FrankBetances/proyecto-lua/renders/muneco-iso.png

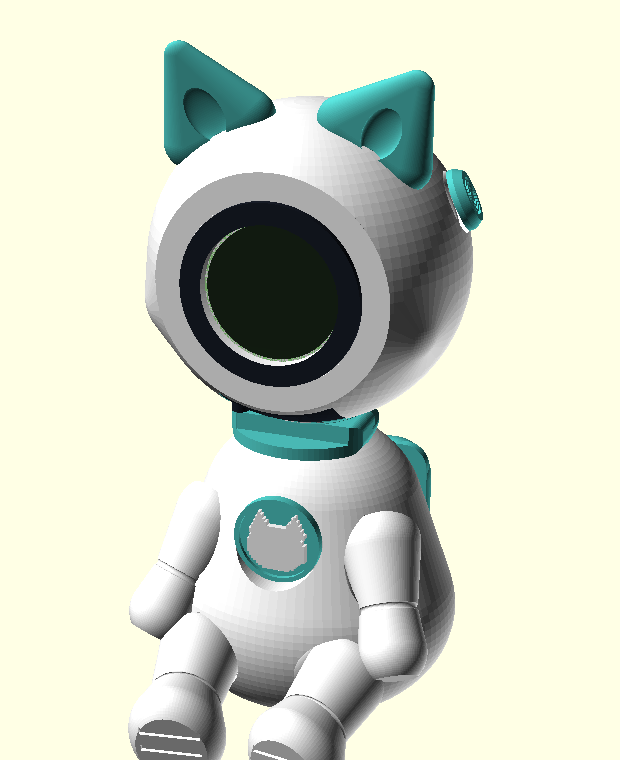
renders/muneco-iso.png
