FrankBetances/proyecto-lua/stl/cabeza_dorso.stl

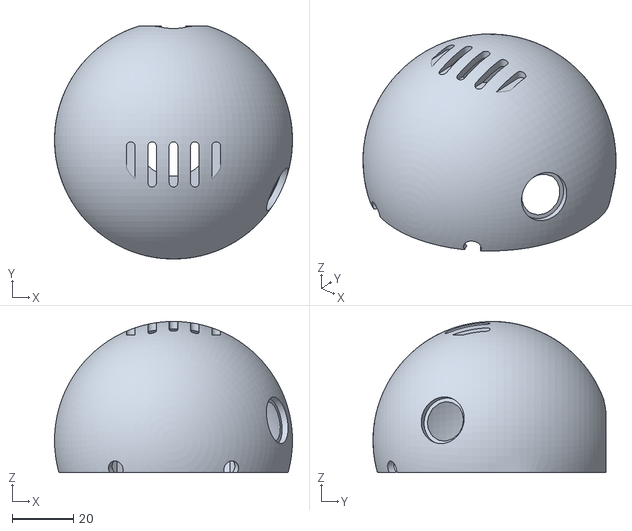
[picture p2: CAD file, 2026-09-15]
stl/cabeza_dorso.stl
78.0 x 76.3 x 49.5
