FrankBetances/proyecto-lua/stl/oreja_izq.stl

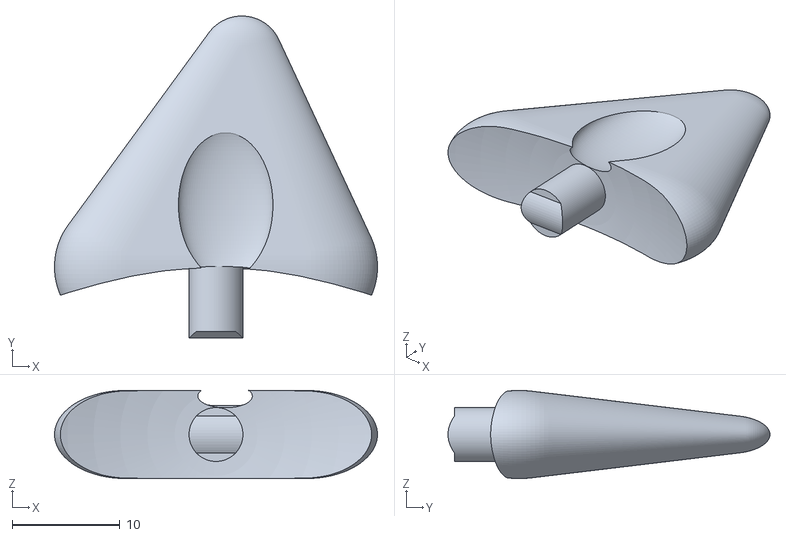
[picture p3: CAD file, 2026-09-15]
stl/oreja_izq.stl
30.0 x 29.9 x 8.18
