FrankBetances/proyecto-lua/stl/brazo_izq.stl

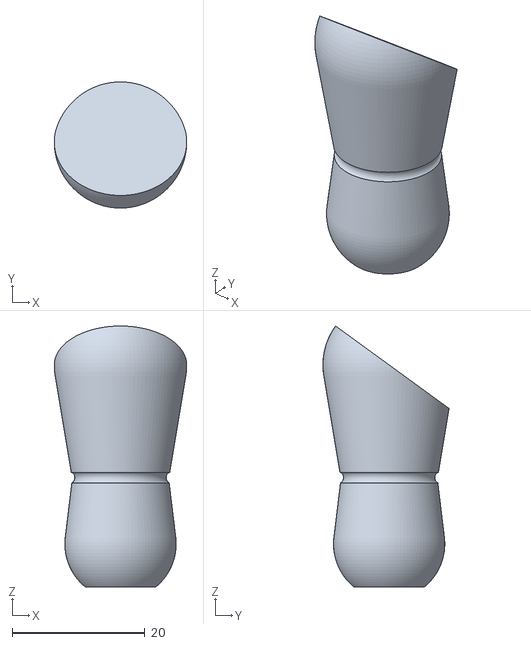
[picture p4: CAD file, 2026-09-15]
stl/brazo_izq.stl
20.0 x 19.0 x 39.4
