FrankBetances/proyecto-lua/stl/pierna_der.stl

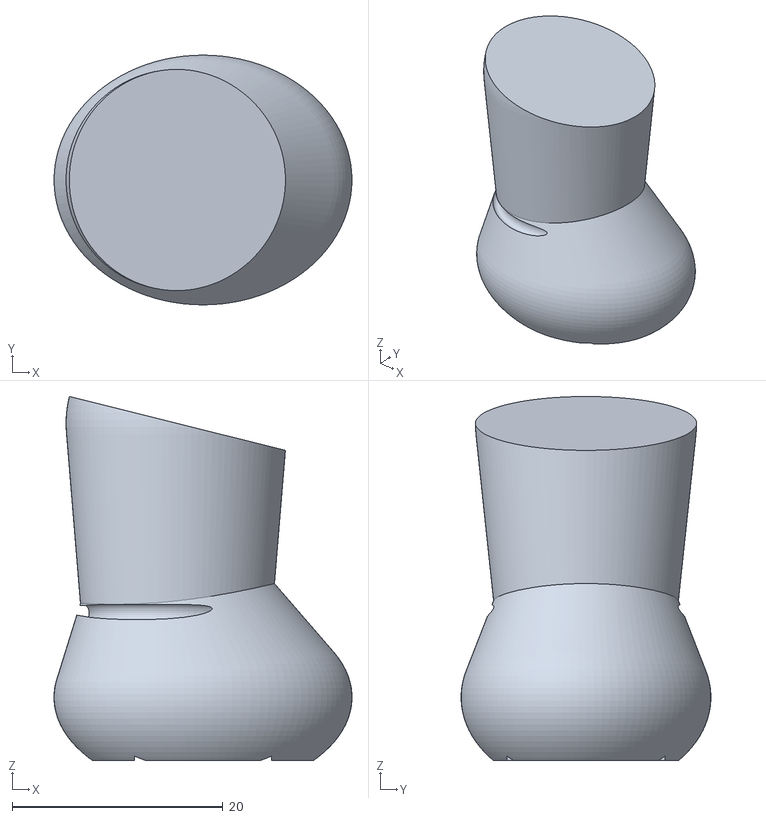
[picture p5: CAD file, 2026-09-15]
stl/pierna_der.stl
28.3 x 23.7 x 34.5
