FrankBetances/proyecto-lua/stl/cartucho.stl

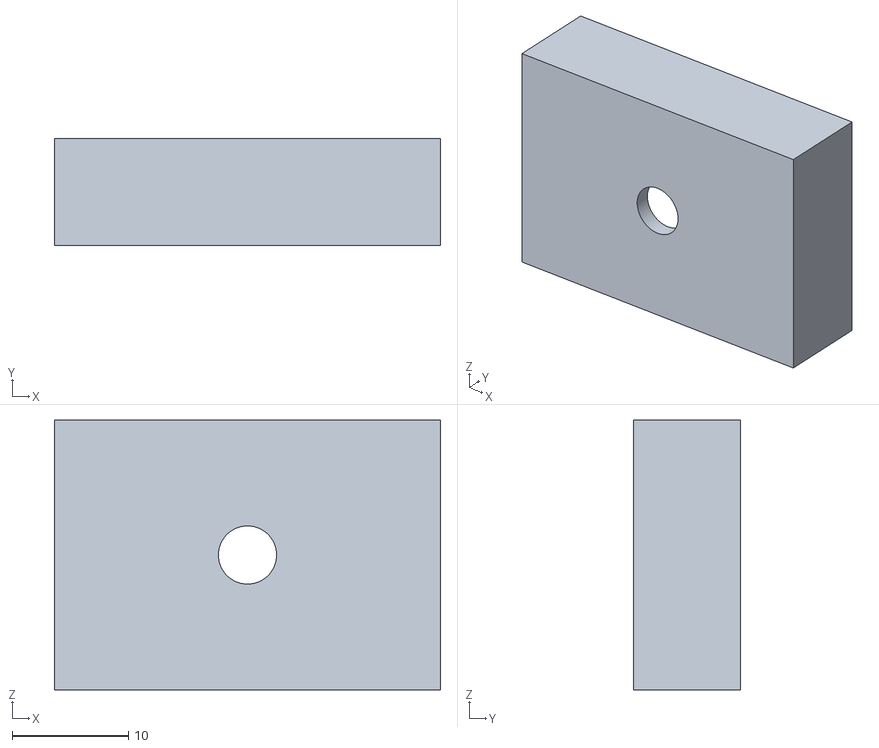
[picture p6: CAD file, 2026-09-15]
stl/cartucho.stl
33.2 x 9.20 x 23.2
