FrankBetances/proyecto-lua/stl/anillo_placa.stl

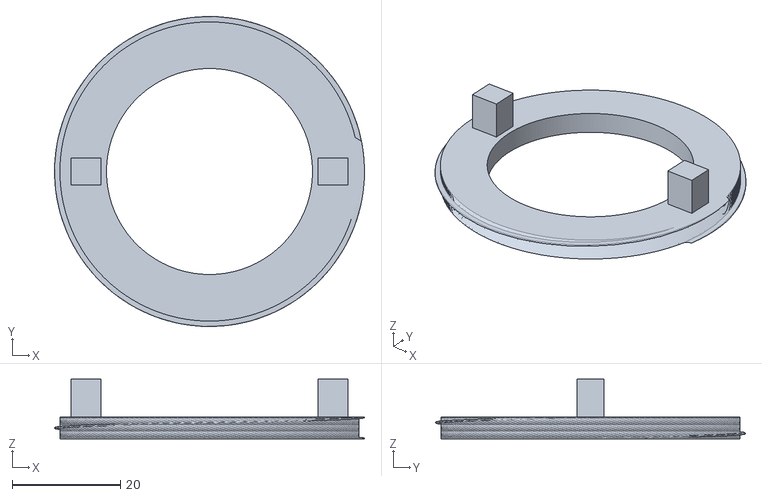
[picture p7: CAD file, 2026-09-15]
stl/anillo_placa.stl
57.2 x 57.2 x 11.0
