FrankBetances/proyecto-lua/stl/testigo_placa.stl

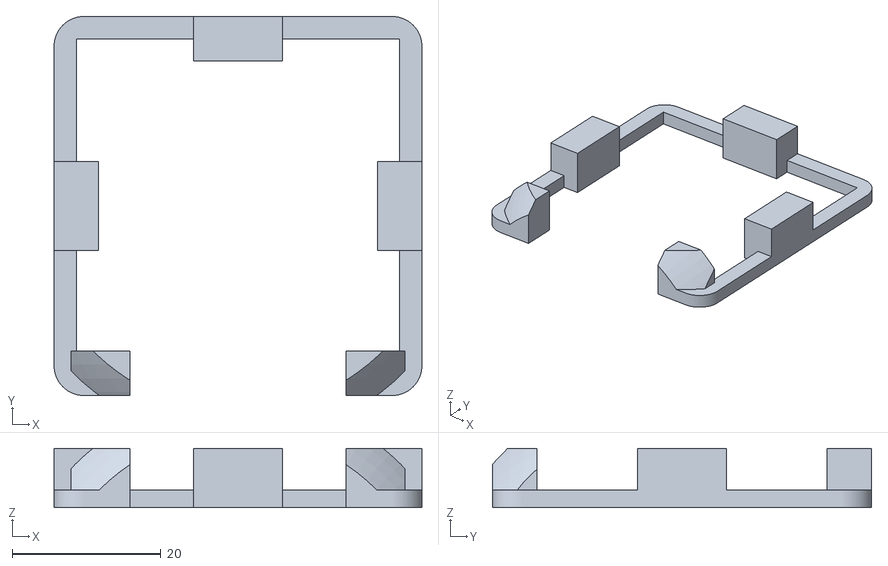
[picture p8: CAD file, 2026-09-15]
stl/testigo_placa.stl
49.5 x 51.0 x 8.00
