FrankBetances/proyecto-lua/stl/boton.stl

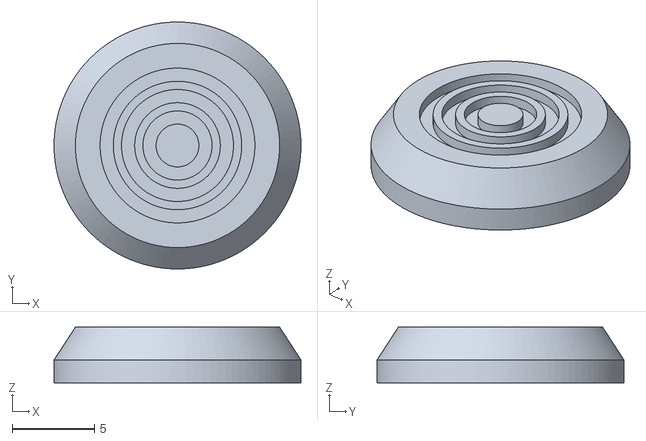
[picture p9: CAD file, 2026-09-15]
stl/boton.stl
15.0 x 15.0 x 3.40
