FrankBetances/proyecto-lua/stl/emblema.stl

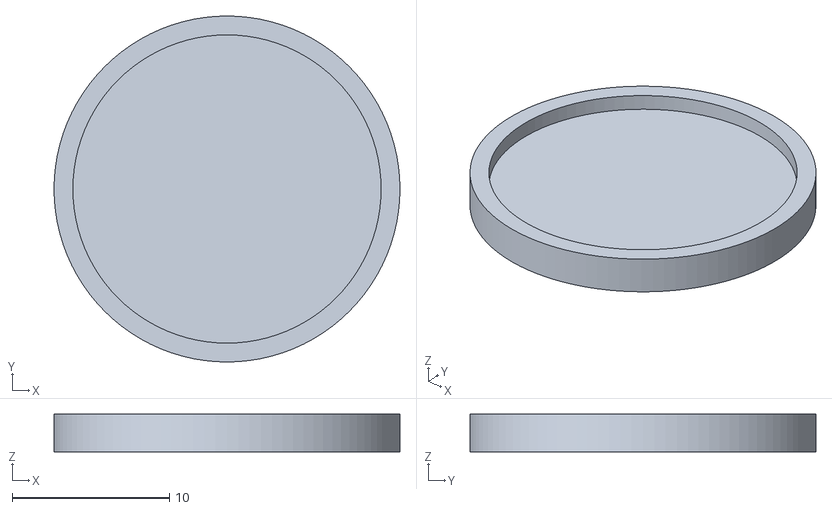
[picture p10: CAD file, 2026-09-15]
stl/emblema.stl
22.0 x 22.0 x 2.40
