FrankBetances/proyecto-lua/stl/testigo_rosca.stl

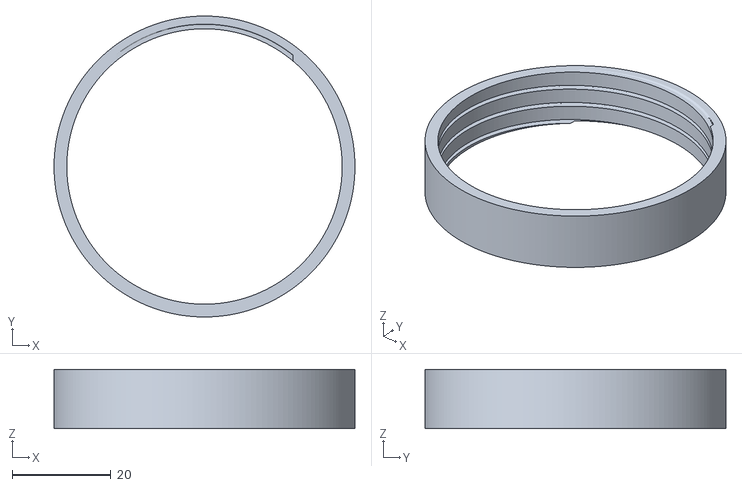
[picture p11: CAD file, 2026-09-15]
stl/testigo_rosca.stl
61.0 x 61.0 x 12.0
