FrankBetances/proyecto-lua/stl/collar.stl

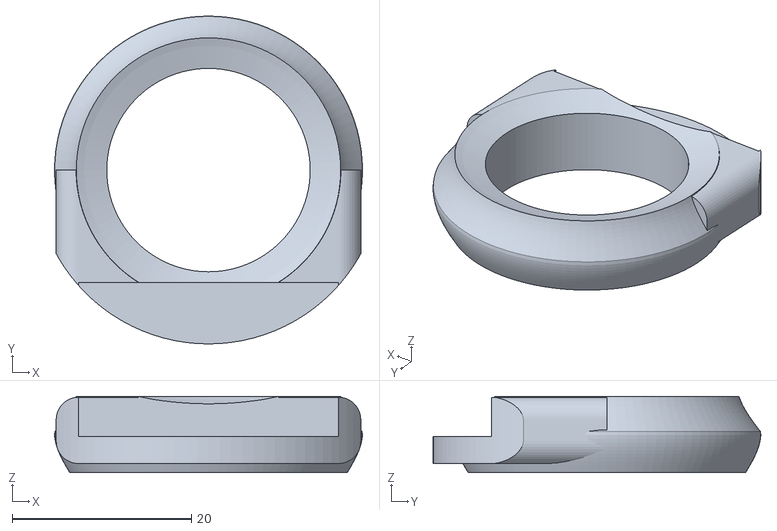
[picture p12: CAD file, 2026-09-15]
stl/collar.stl
34.4 x 36.6 x 8.49
