FrankBetances/proyecto-lua/stl/mochila.stl

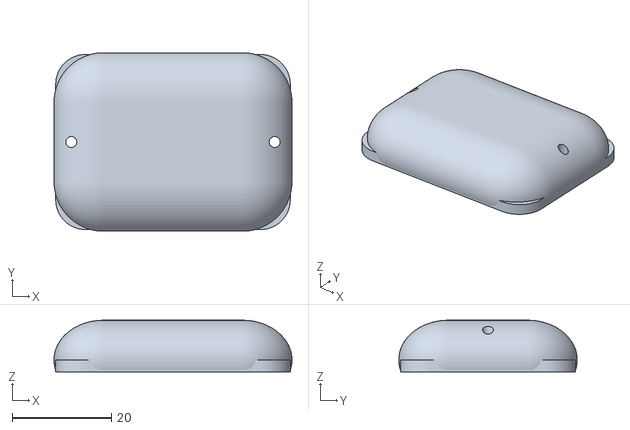
[picture p13: CAD file, 2026-09-15]
stl/mochila.stl
48.0 x 36.0 x 10.4
