FrankBetances/proyecto-lua/stl/cabeza_frente.stl

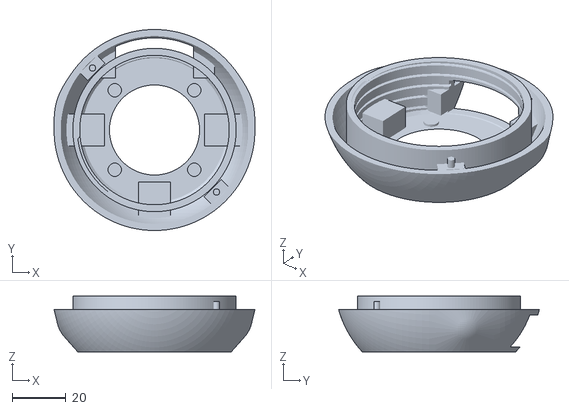
[picture p14: CAD file, 2026-09-15]
stl/cabeza_frente.stl
75.1 x 75.1 x 20.9
