FrankBetances/proyecto-lua/stl/pulsadores.stl

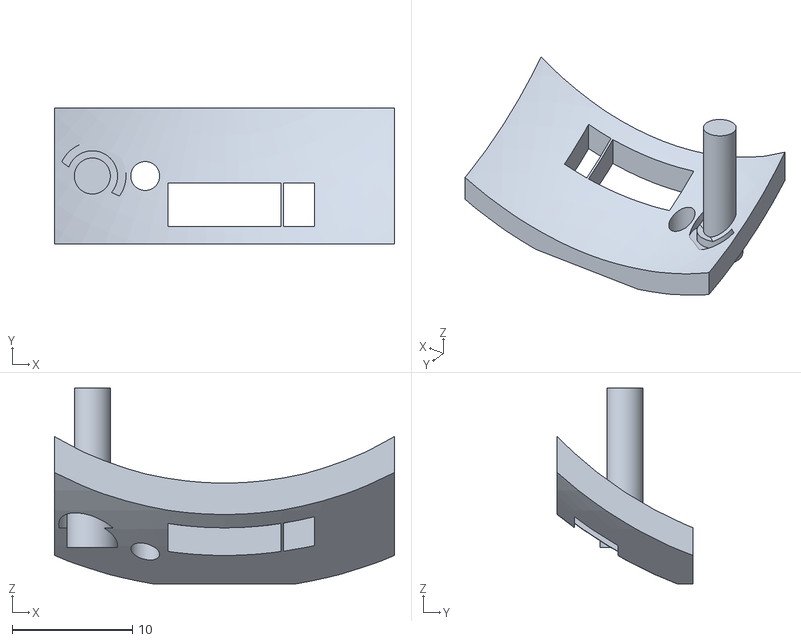
[picture p15: CAD file, 2026-09-15]
stl/pulsadores.stl
28.3 x 11.3 x 16.3
