FrankBetances/proyecto-lua/stl/logo.stl

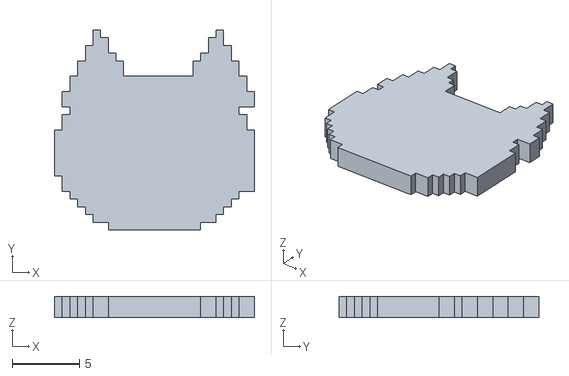
[picture p16: CAD file, 2026-09-15]
stl/logo.stl
14.9 x 14.9 x 1.60
