FrankBetances/proyecto-lua/stl/cuerpo.stl

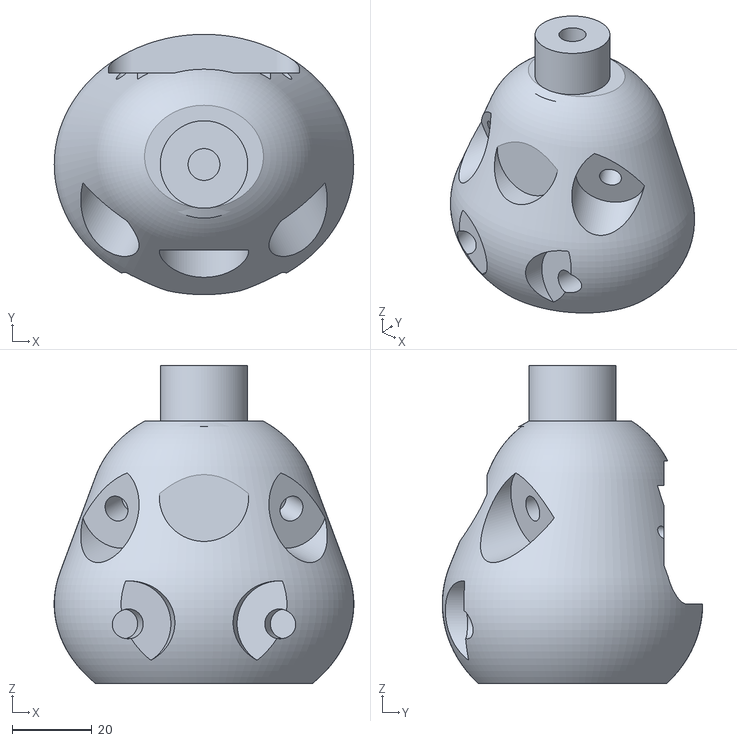
[picture p17: CAD file, 2026-09-15]
stl/cuerpo.stl
75.4 x 65.5 x 80.0
