FrankBetances/proyecto-lua/stl/aro_visor.stl

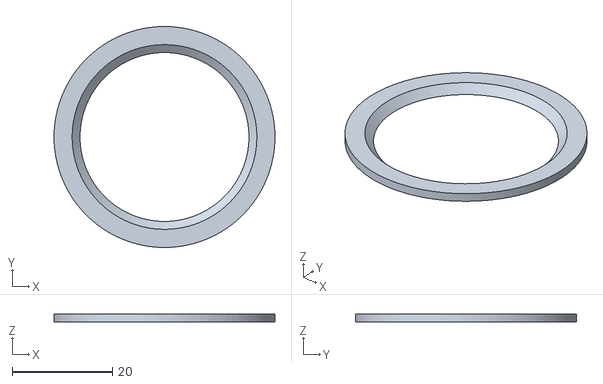
[picture p18: CAD file, 2026-09-15]
stl/aro_visor.stl
44.0 x 44.0 x 1.60
