FrankBetances/proyecto-lua/(list of files, cad)

Other CAD files:
stl/pierna_izq.stl
stl/oreja_der.stl
stl/brazo_der.stl
lua_muneco_estilizado.blend
