FrankBetances/proyecto-lua/skills/stylized-3d-print-expert/references/01_por_que_falla_openscad_y_anatomia_chibi.md

# 01 · Por Qué Falla OpenSCAD y la Anatomía del Modelado Chibi Profesional

## 1. El Diagnóstico: ¿Por Qué OpenSCAD Produce Resultados Toscos e Infantiles al Partir de una Foto?

Cuando un diseñador o ingeniero intenta trasladar una ilustración 2D o render a un archivo STL mediante **OpenSCAD**, el resultado casi invariablemente luce rígido, facetado, tosco y con aspecto de "juguete barato o hecho por un niño". 

Esto no se debe a la falta de destreza del operador, sino a la **naturaleza matemática del motor de OpenSCAD**:

### A. Geometría Constructiva de Sólidos (CSG) vs. Superficies Orgánicas
- **OpenSCAD es un motor CSG basado en álgebra booleana rígida**: une (`union()`), resta (`difference()`) e intersecta (`intersection()`) primitivas analíticas (cubos, cilindros, esferas y conos).
- **Inexistencia de continuidad G2/G3 (Curvature Continuity)**:
  - En OpenSCAD, la unión de dos formas (ej. la cabeza esférica y el torso) genera una arista viva de intersección en **continuidad G0** (simple contacto de posición).
  - En el diseño de personajes profesional (como Disney, Pixar, Pop Mart o Nendoroid), las transiciones entre volúmenes orgánicos requieren **continuidad G2** (continuidad de curvatura sin saltos bruscos en el vector normal de la superficie).
- **El fallo de `surface()` y `linear_extrude()`**:
  - Convertir una foto en mapa de alturas (`surface()`) genera un relieve 2.5D escalonado y ruidoso ("efecto moneda o sello tallado").
  - Extruir un SVG (`linear_extrude()`) produce un bloque plano tipo cortador de galletas con paredes verticales de 90°.
- **La trampa de `hull()` (Envolvente convexa)**:
  - OpenSCAD intenta salvar curvas uniendo esferas con `hull()`. El resultado es una figura geométrica hinchada y rígida (tipo "muñeco de nieve inflable" o "globo"), carente de mejillas carnosas, líneas de expresión facial, pliegues naturales y micro-biseles.

---

## 2. Los Fundamentos del Modelado Estilizado Profesional (Estética Chibi / Kawaii / Toy)

Para que un modelo 3D resulte inmediatamente adorable, tierno y atractivo para niñas y niños, debe seguir los cánones de la anatomía estilizada (**Chibi / Toy Art**):

```
         ┌─────────────────────────┐
         │       CABEZA Ø          │  ◄── Proporción 1:1 o 1:1.2 respecto al cuerpo
         │   (Esfera achatada      │      Frente amplia, barbilla reducida
         │    con mejillas bajas)  │
         └───────────┬─────────────┘
                     │ (Cuello corto / collarín)
         ┌───────────┴─────────────┐
         │      TORSO COMPACTO     │  ◄── Forma de pera o gota invertida
         │   (Brazos y piernas     │      Cero ángulos rectos; todo redondeado
         │    cortos y regordetes) │
         └─────────────────────────┘
```

### Reglas Anatómicas del Personaje Pediátrico:
1. **Ratio Cabeza-Cuerpo (1:1 a 1:1.5)**:
   - Los niños pequeños y cachorros tienen la cabeza proporcionalmente enorme respecto al cuerpo. Este rasgo desencadena biológicamente el instinto de protección y ternura (*Kindchenschema* de Konrad Lorenz).
2. **Plano Facial Bajo y Ojos Separados**:
   - Los ojos y elementos expresivos deben ubicarse en el **tercio inferior** de la cabeza, nunca a la mitad.
   - El puente nasal y barbilla deben ser mínimos o redondeados, con mejillas abombadas que sobresalgan lateralmente.
3. **Micro-Biseles y Superficies de Tensión (Bevel & Soft Creases)**:
   - En una figura física de vinilo o resina profesional, **no existe ningún borde vivo de 90°**. Todo cambio de plano lleva un redondeo mínimo de radio $R \ge 0.8\text{ mm}$ a $1.5\text{ mm}$, lo que permite que la luz cree reflejos suaves (*highlights especulares*) y no reflejos duros.
4. **Curvatura Continua en Silueta**:
   - Las siluetas deben fluir en arcos continuos. Los accesorios (como mochilas, cascos o antenas) deben acoplarse orgánicamente siguiendo la tensión de la masa muscular o estructural del personaje.

---

## 3. La Transición Tecnológica: De OpenSCAD a Mallas Neuronales y Blender `bpy`

Para lograr que el modelo sea **100% idéntico a la foto original**, el flujo de trabajo moderno reemplaza el código CSG por:

| Característica | OpenSCAD (Flujo Obsoleto) | Pipeline Estilizado (Blender + IA) |
| :--- | :--- | :--- |
| **Entrada** | Primitivas matemáticas manuales | Foto 2D / Render directo |
| **Fidelidad al boceto** | 20% - 40% (aproximación burda) | **95% - 100% (captura volumétrica exacta)** |
| **Curvatura** | Facetada ($fn$) o discontinua (G0) | **Subdivision Surfaces / Voxel Smooth (G2)** |
| **Tiempo de iteración** | Días escribiendo coordenadas | **Minutos (reconstrucción + acondicionamiento)** |
| **Acabado final** | Bloques toscos de corte técnico | **Figura coleccionable estilo Pop Mart / Nendoroid** |
| **Aptitud para FDM** | Frecuentes aristas no-manifold en uniones complejas | **Malla estanca 2-Manifold limpia garantizada** |

La clave reside en usar las herramientas adecuadas para cada fin:
- **OpenSCAD / FreeCAD**: Excelente para soportes de PCB, cajas con tornillos M3 y roscas métricas industriales.
- **Blender + Motores Neuronales Image-to-3D**: El único método viable para figuras, mascotas, personajes orgánicos y juguetes estilizados profesionales.
