FrankBetances/proyecto-lua/(commit log)

2026-09-15 chore: initial commit — Proyecto Lua V14
    [anillo_placa.stl, aro_visor.stl, boton.stl, brazo_der.stl, brazo_izq.stl, cabeza_dorso.stl, cabeza_frente.stl, cartucho.stl]
2026-09-15 docs: manual de ensamble estilo IKEA para mascota Lúa V14
    - MANUAL_ENSAMBLE_LUA.md: 10 pasos ilustrados con advertencias
    - 10 ilustraciones generadas con IA (estilo línea limpia IKEA)
    - Inventario visual de las 20 piezas STL
    - Rutas relativas a renders/ para visualización en GitHub
2026-09-16 fix(manual): reconstruir manual con renders CAD reales eliminando ilustraciones inventadas
2026-09-16 fix(manual): integrar diagramas vectoriales 3D explosionados derivados de los STL reales con flechas de montaje
2026-09-16 feat(manual): Add generated IKEA style assembly manual and scripts
2026-10-23 docs: crear README.md con arquitectura de juguete STEAM con bloques tipo LEGO y Realidad Aumentada
2026-10-26 docs(readme): restaurar README original de proyecto-lua (el cambio pertenecia a lua-firmware)
2026-10-28 docs(readme): actualizar a especificacion V5 mascota STEAM de bloques
2026-10-28 chore(submodule): actualizar puntero lua-firmware con plan de prueba V5
2026-10-28 docs: agregar plan detallado de la version de prueba V5
